thiasotiks/Audio-Preamplifier-With-3-band-Equalizer/README.md

# Audio-Preamplifier-With-3-band-Equalizer 
This repo contains the PCB layout and circuit diagram for audio preamplifier with *3 band equalizer* and *crossover* filter for subwoofer.<br/><br/><br/>

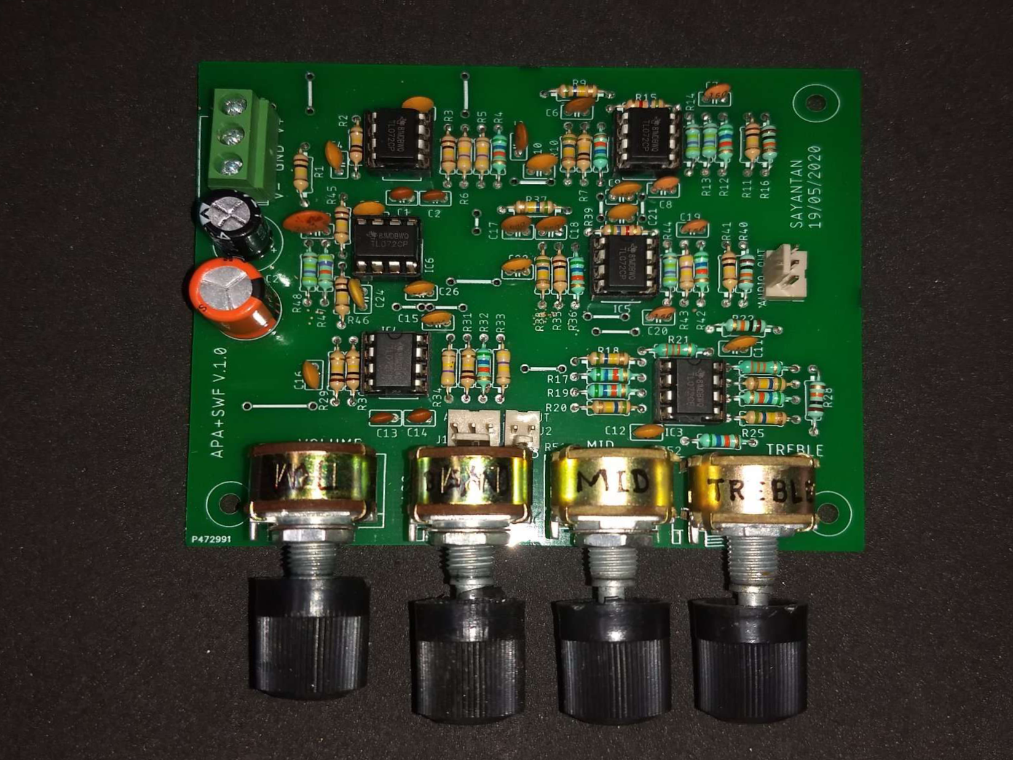
[picture p1: image/circuit-in-use.png]
CIRCUIT IN USE

<br/>**Figure:** The preamplifier circuit board

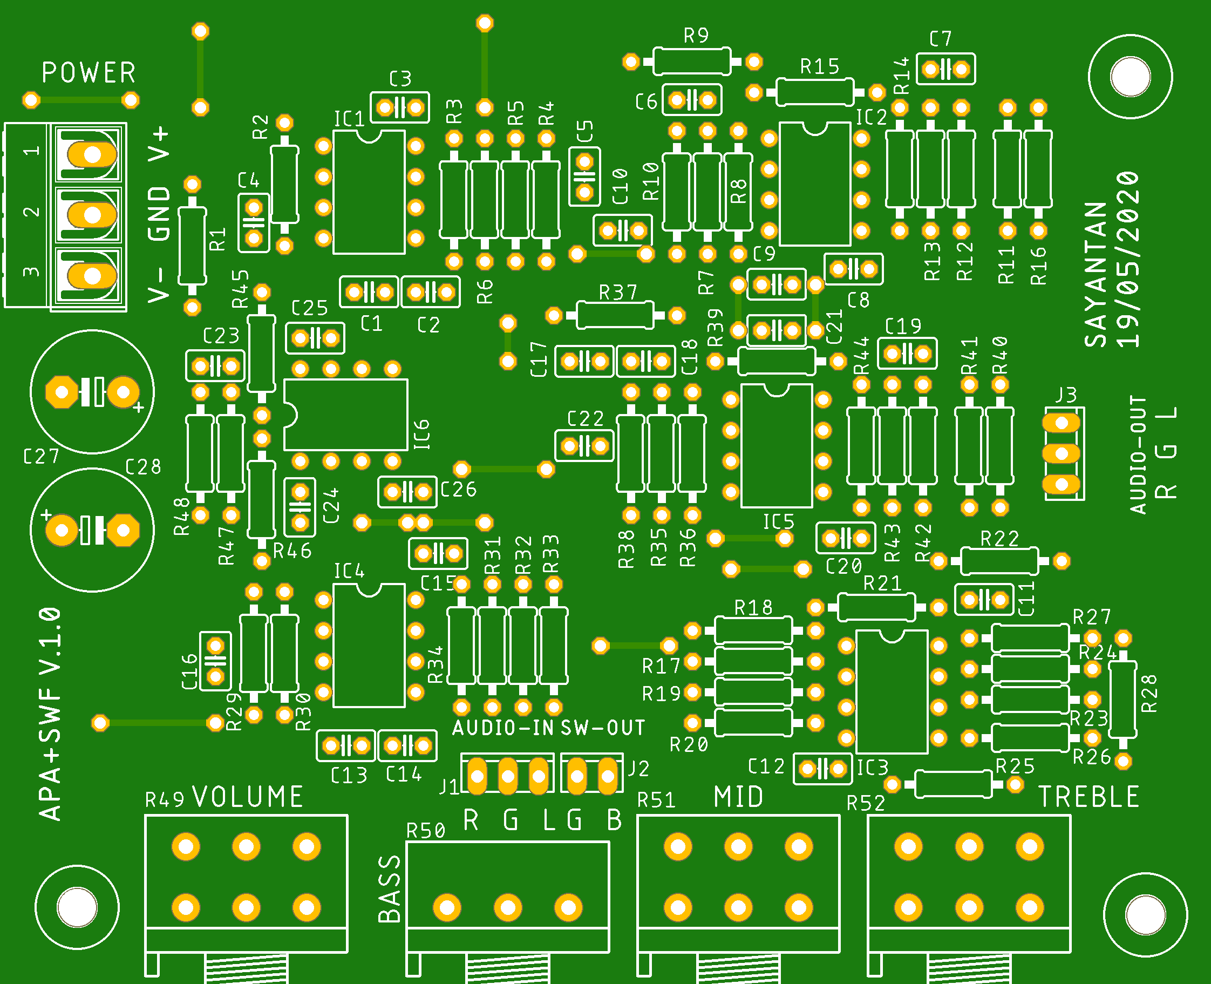
[picture p2: image/pcb-top.png]
PCB TOP

<br/>**Figure:** PCB top

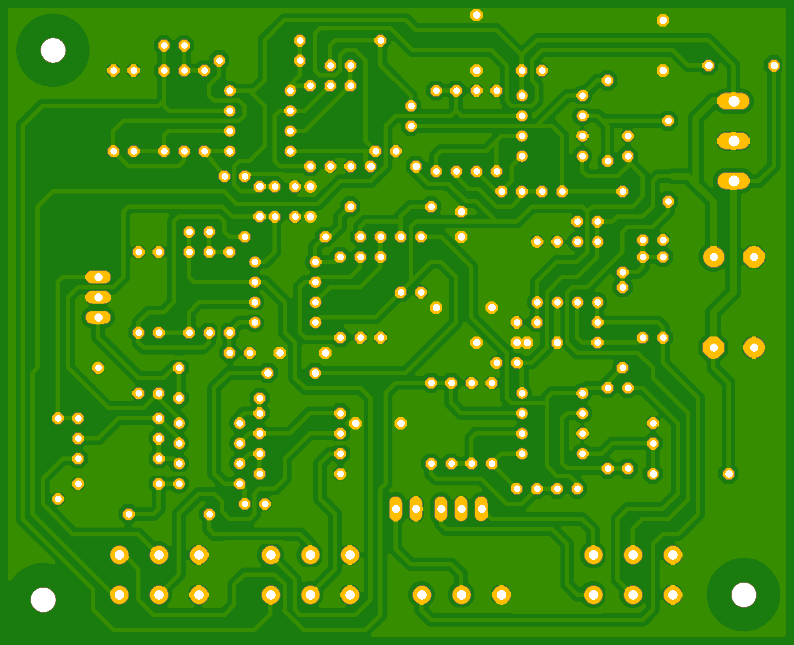
[picture p3: image/pcb-bottom.png]
PCB BOTTOM

<br/>**Figure:** PCB bottom

## Table of damping ratio for designing Butterworth filter of different orders.
|Order||Stages|||
|-----|---|---|-----|-----|
|1|Stage-A: <br/>1st Order||||
|2|Stage-A: <br/>2nd Order; k = 0.707||||
|3|Stage-A: <br/>1st Order|Stage-B: <br/>2nd Order; k = 0.5|||
|4|Stage-A: <br/>2nd Order; k = 0.3825|Stage-B: <br/>2nd Order; k = 0.924|||
|5|Stage-A: <br/>1st Order|Stage-B: <br/>2nd Order; k = 0.309|Stage-C: <br/>2nd Order; k = 0.809||
|6|Stage-A: <br/>2nd Order; k = 0.259|Stage-B: <br/>2nd Order; k = 0.707|Stage-C: <br/>2nd Order; k = 0.966||
|7|Stage-A: <br/>1st Order|Stage-B: <br/>2nd Order; k = 0.2225|Stage-C: <br/>2nd Order; k = 0.6235|Stage-D: <br/>2nd Order; k = 0.901|
|8|Stage-A: <br/>2nd Order; k = 0.190|Stage-B: <br/>2nd Order; k = 0.5555|Stage-C: <br/>2nd Order; k = 0.8315|Stage-D: <br/>2nd Order; k = 0.981|
---

>**NOTE:** k is the damping ratio of the filter which decides the response of the filter. Quality factor, Q = 1 / 2k.

## Designing the low-pas filter for BASS band (also acts as a crossover filter for subwoofer)
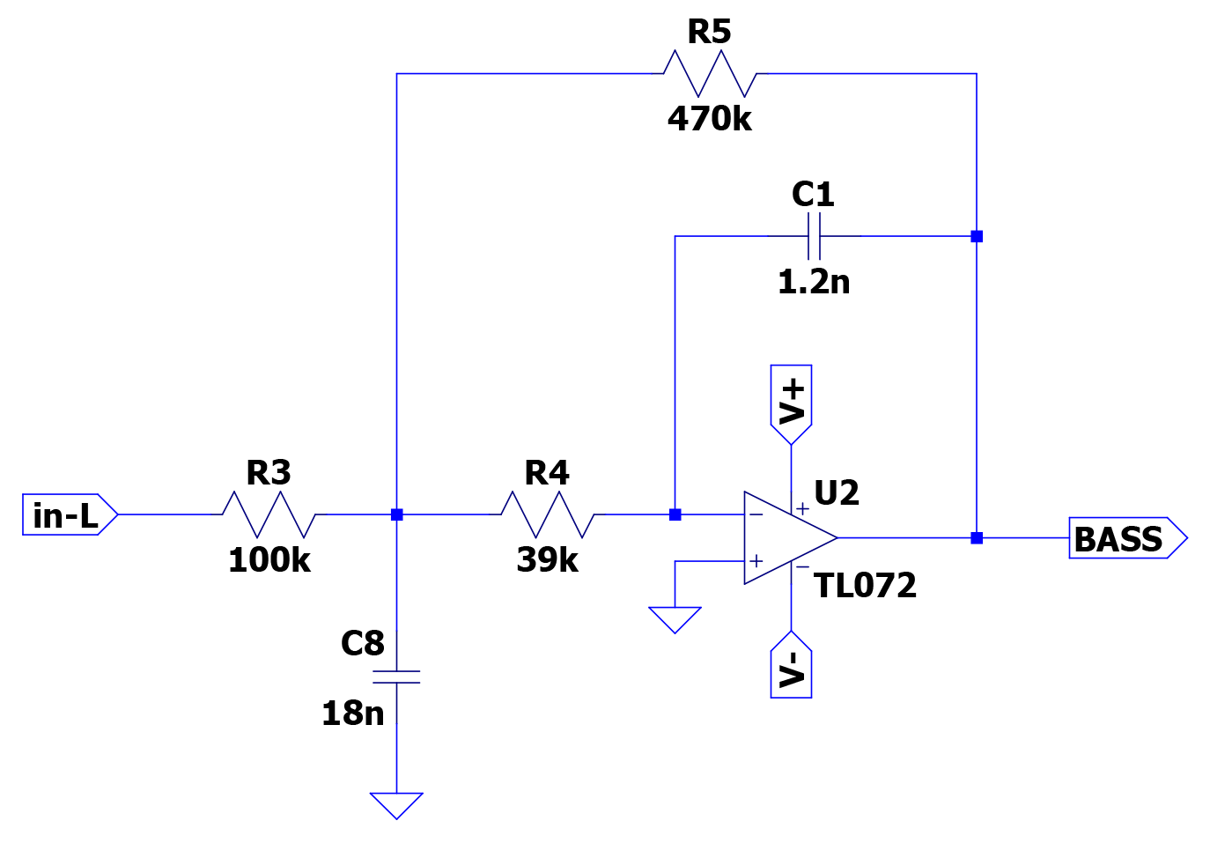
[picture p4: image/lpf-bass.png]
LOW PASS FILTER-BASS

<br/>**Figure:** Low pass filter for BASS-band

**Filter type:** 2nd order Butterworth low-pass, multiple feedback filter <br/>
**Target:** |gain| = 4 (12 dB), cutoff freq., f_c = 250 Hz, k = 0.707 <br/>
**Designed:**
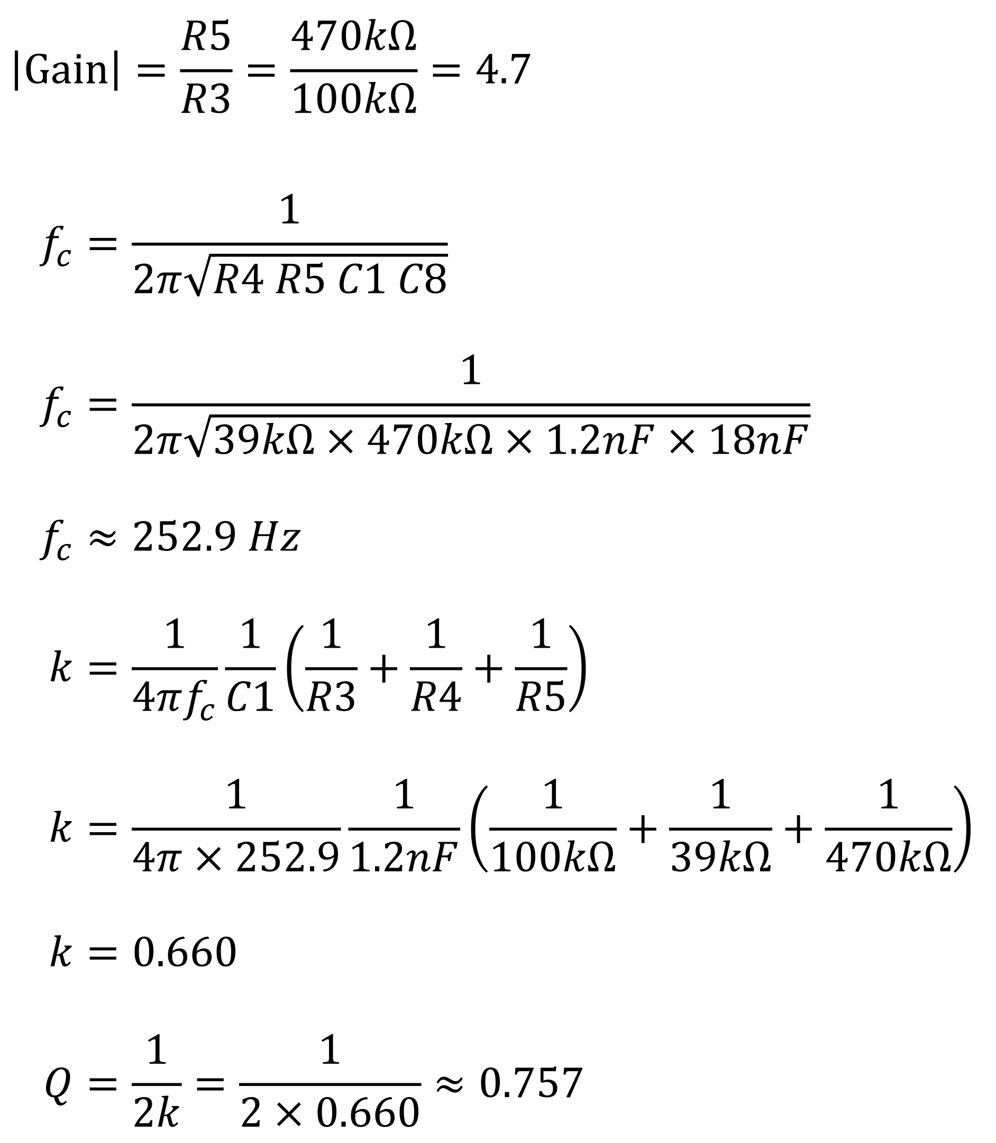
[picture p5: image/bass-filter-calc.png]
BASS FILTER CALC


## Designing the band-pass filter for MID band
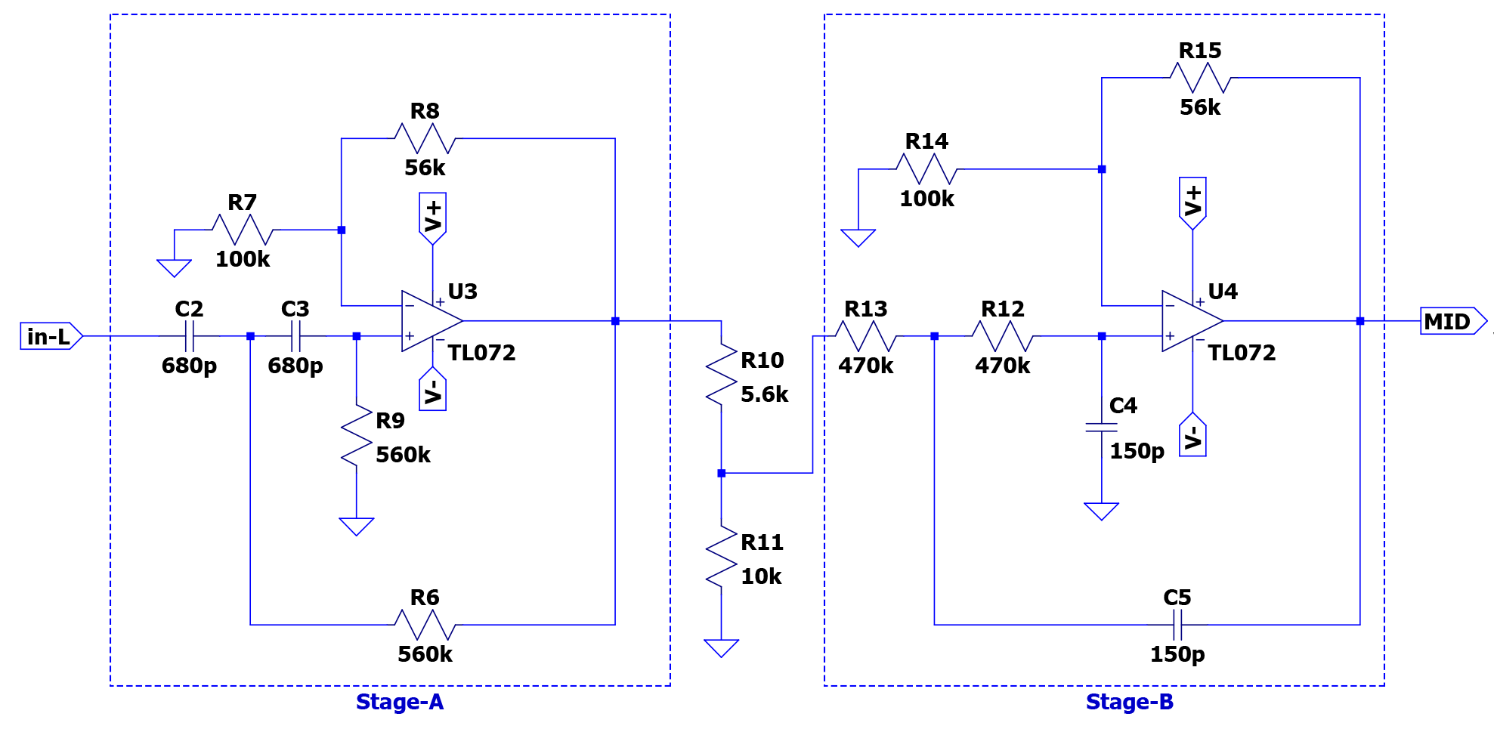
[picture p6: image/bpf-mid.png]
BAND PASS FILTER-MID

<br/>**Figure:** Band pass filter for MID-band

**Filter type:** 2nd order mid-pass, cascade two Sallen-Key filters (stage-A & stage-B) <br/>
### Stage-A (2nd order Butterworth high-pass filter)
**Target:** gain = 3 - 2k = 3 - 2 * 0.707 = 1.586, f_c = 420 Hz, k = 0.707 <br/>
**Designed:**
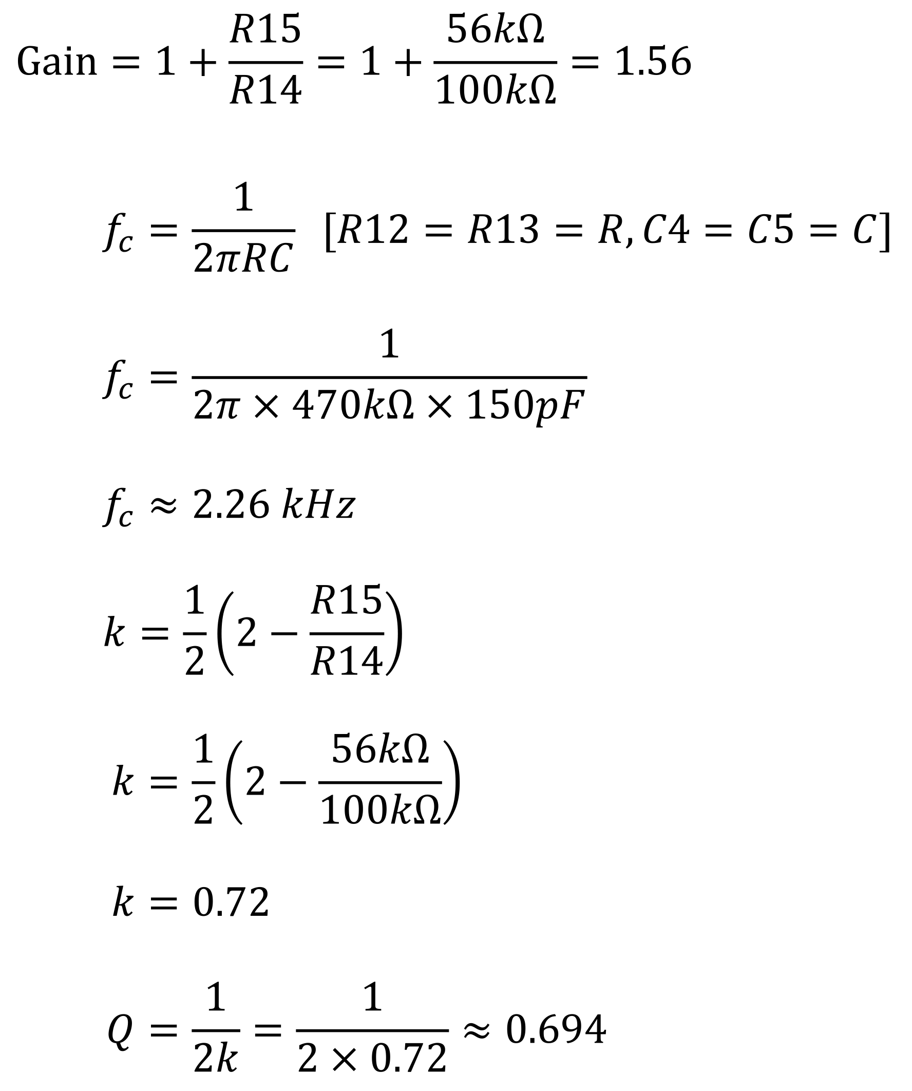
[picture p7: image/mid-filter-a-calc.png]
MID FILTER A CALC


### Stage-B (2nd order Butterworth low-pass filter)
**Target:** gain = 3 - 2k = 3 - 2 * 0.707 = 1.586, f_c = 2.30 kHz, k = 0.707 <br/>
**Designed:**
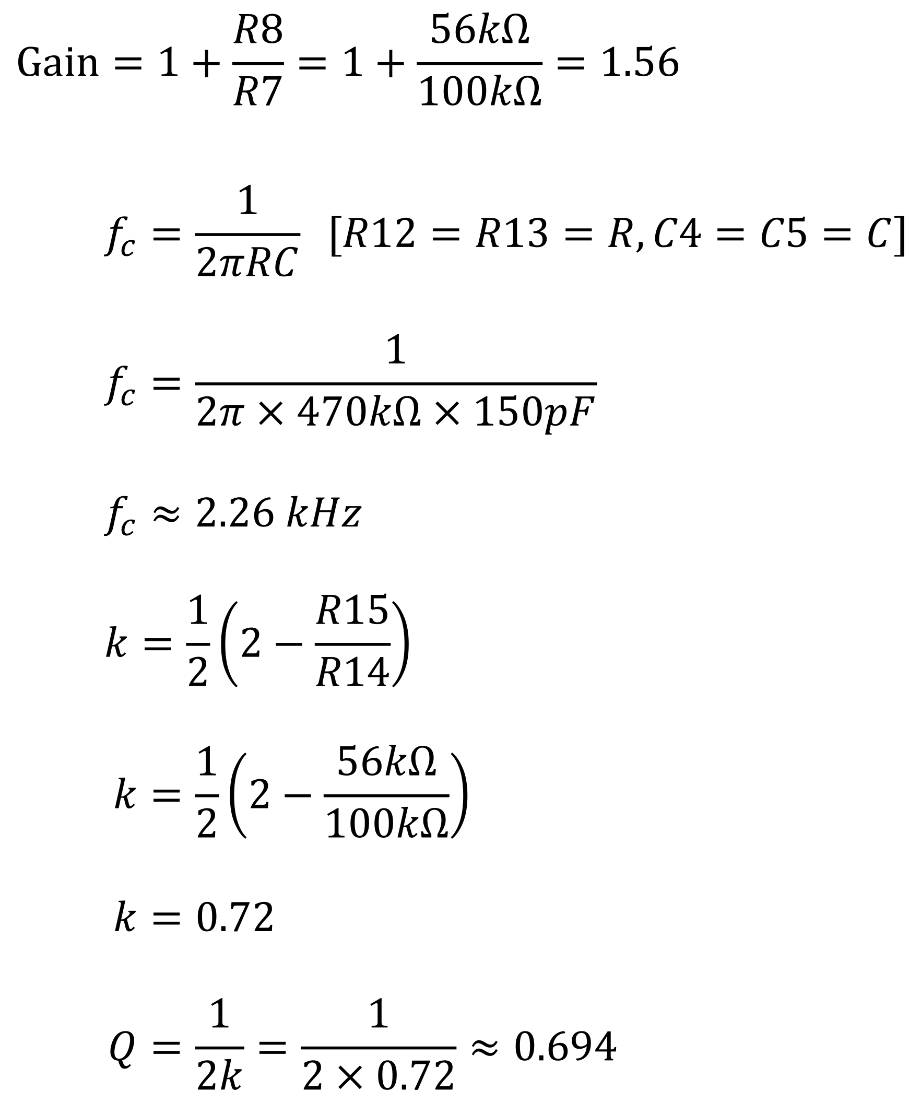
[picture p8: image/mid-filter-b-calc.png]
MID FILTER B CALC


## Designing the low-pass filter for TREBLE band
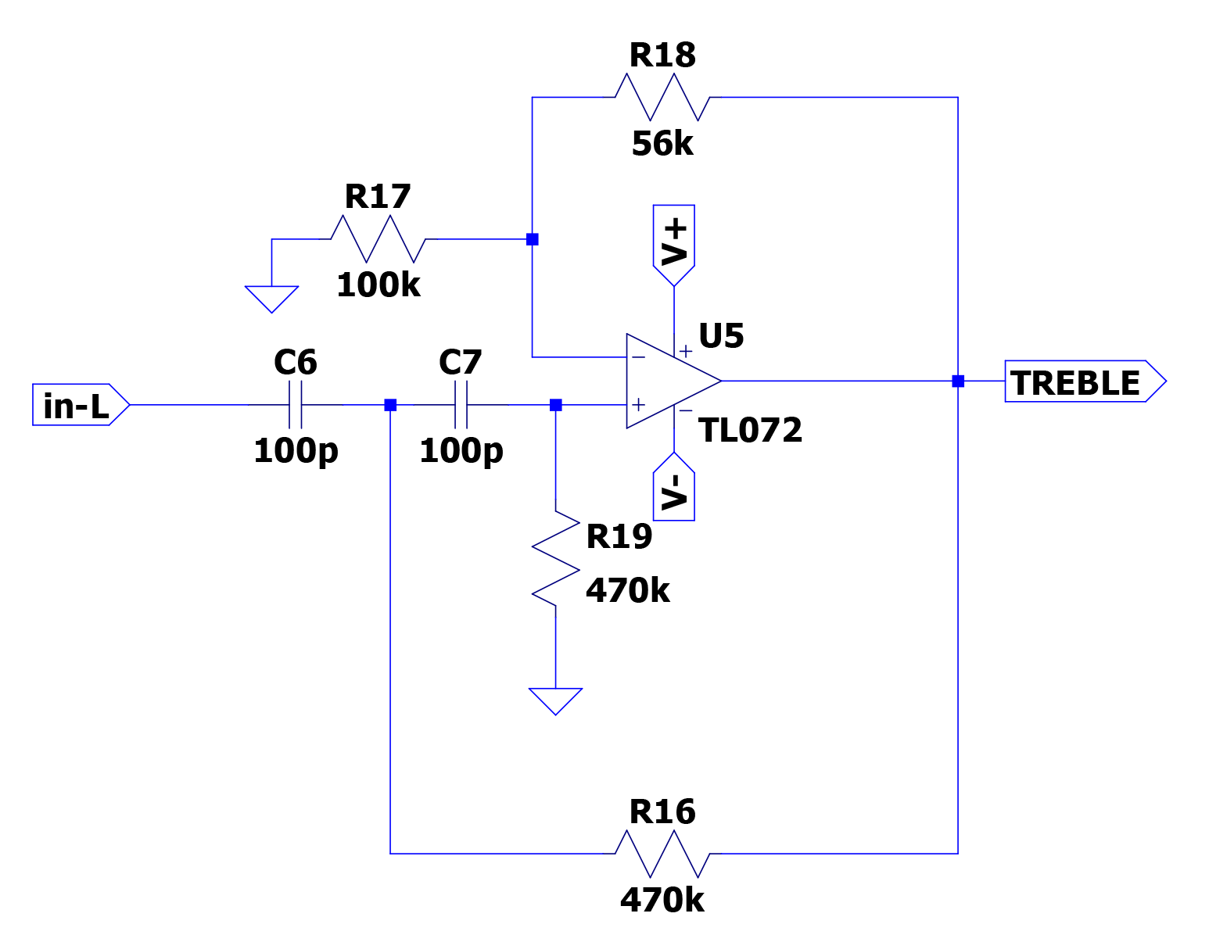
[picture p9: image/hpf-treble.png]
LOW PASS FILTER-TREBLE

<br/>**Figure:** Low pass filter for TREBLE-band

**Filter type:** 2nd order Butterworth low-pass, Sallen-Key filter <br/>
**Target:** gain = 3 - 2k = 3 - 2 * 0.707 = 1.586, f_c = 3.30 kHz, k = 0.707 <br/>
**Designed:**
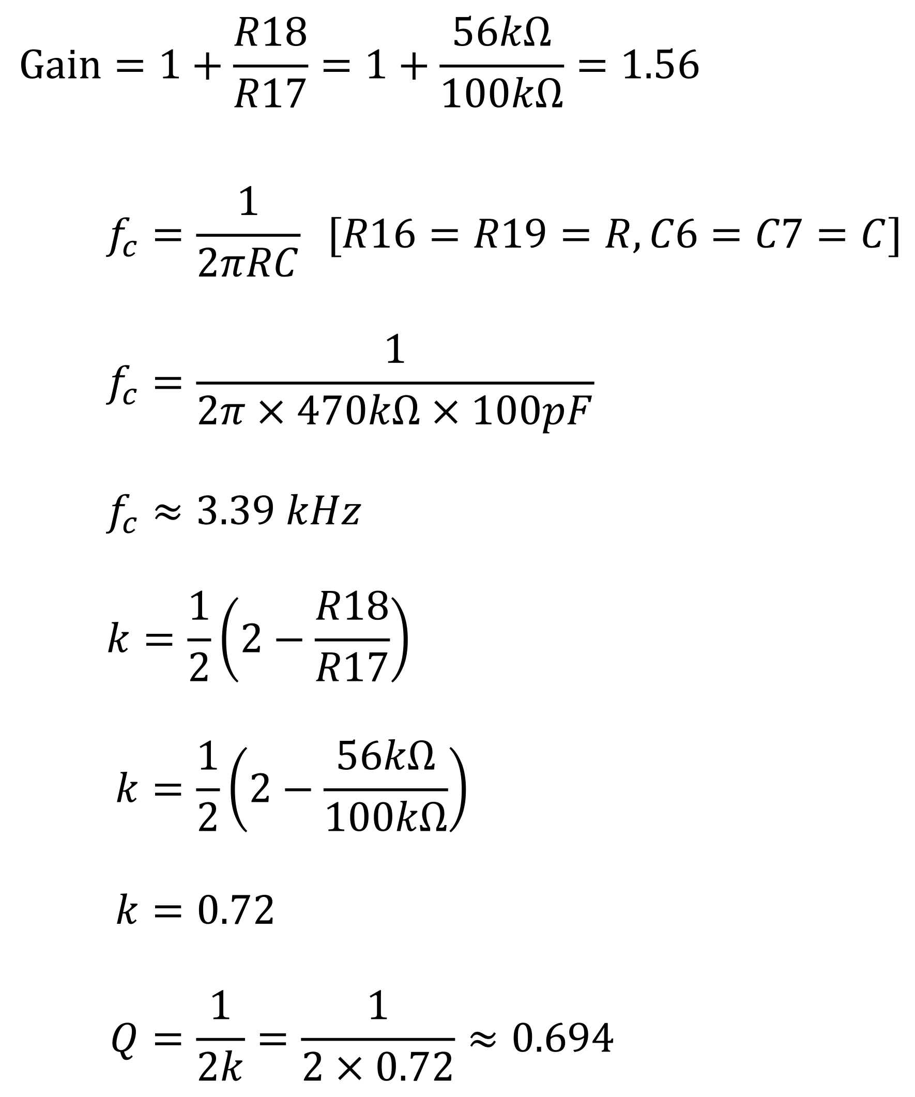
[picture p10: image/treble-filter-calc.png]
TREBLE FILTER CALC


>**NOTE:** Before running simulation in LT Spice "potentiometer.asc" & "potentiometer.asy" must be copied to appropriate symbol folder (e.g. C:\Users\<User Name>\Documents\LTspiceXVII\lib\sym) and copy the TL072.LIB to the "sub" folder (e.g. C:\Users\<User Name>\Documents\LTspiceXVII\lib\sub)

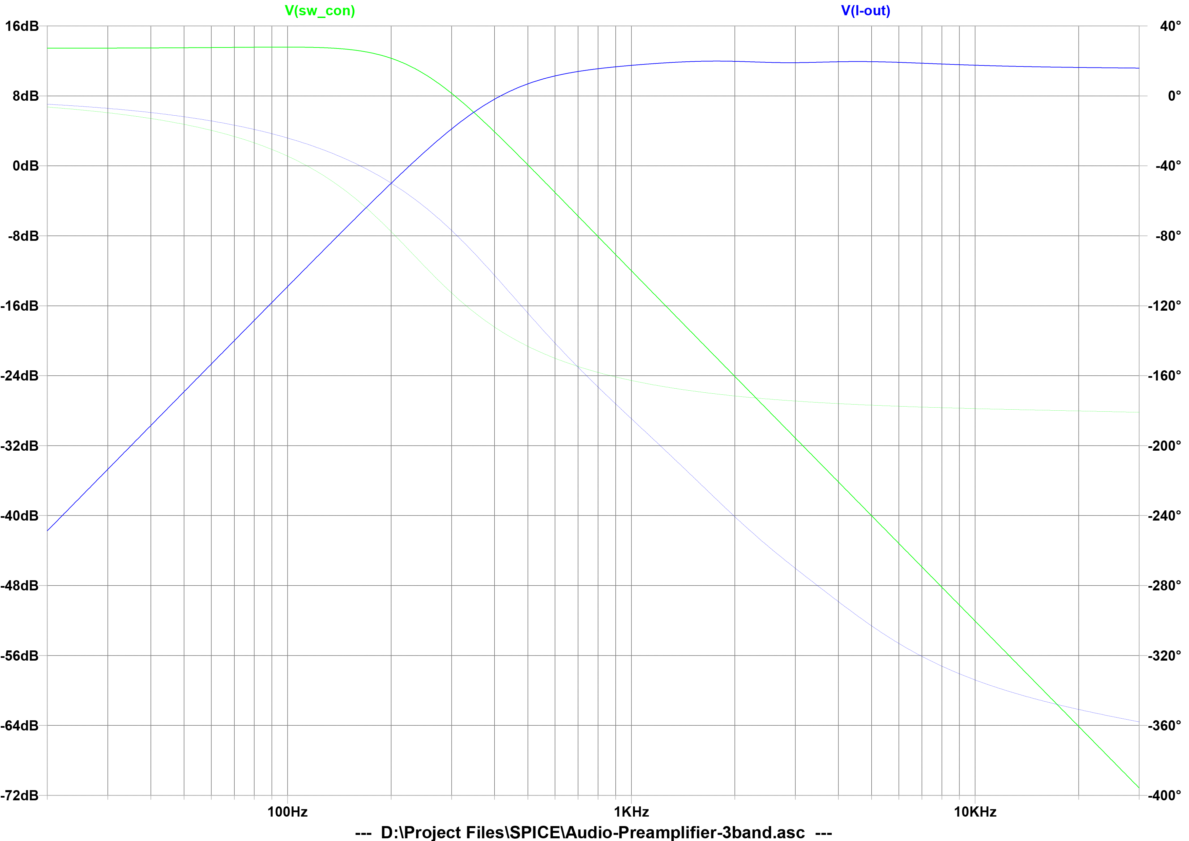
[picture p11: image/Audio-Preamplifier-3band-Response-100-100-100.png]
OUTPUT CURVE-B-100%, M-100%, T-100%

<br/>**Figure:** OUTPUT CURVE-BASS=100%, MID=100%, TREBLE=100%

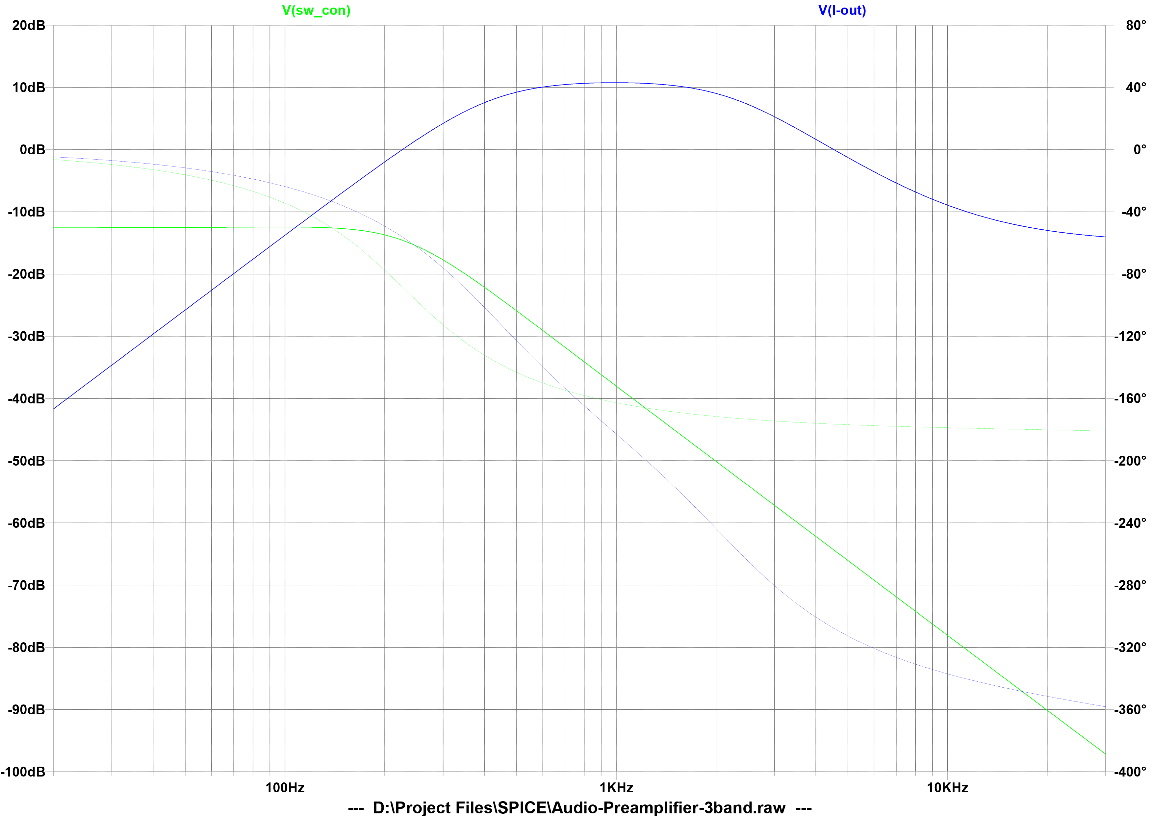
[picture p12: image/Audio-Preamplifier-3band-Response-5-100-5.png]
OUTPUT CURVE-B-5%, M-100%, T-5%

<br/>**Figure:** OUTPUT CURVE-BASS=5%, MID=100%, TREBLE=5%

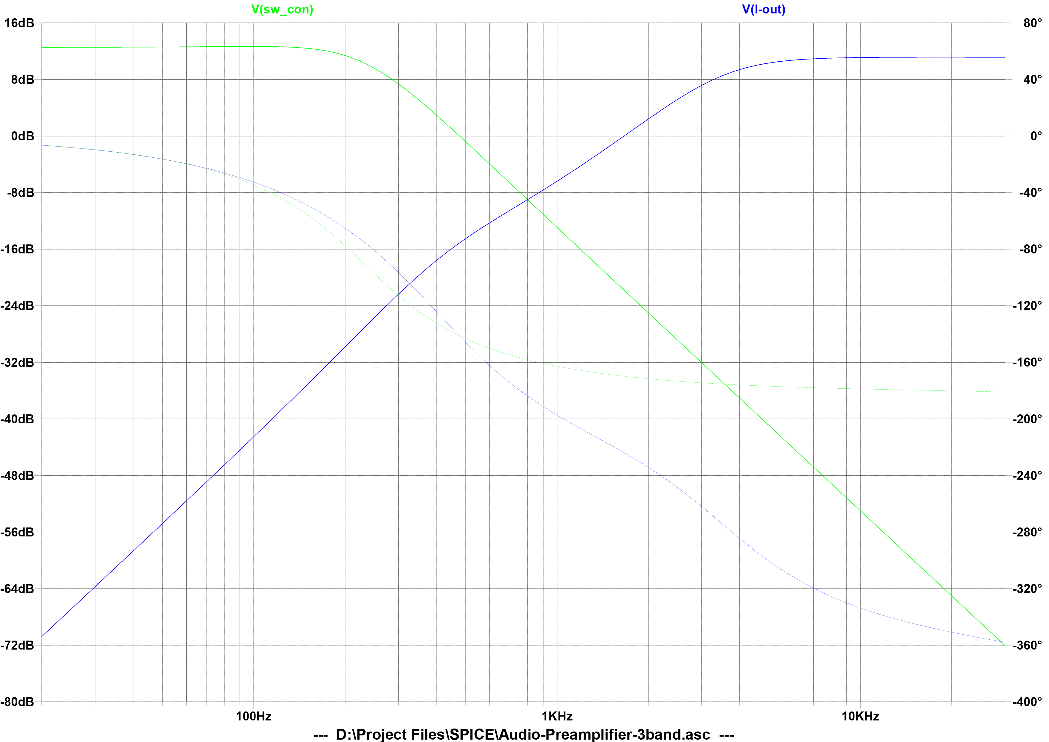
[picture p13: image/Audio-Preamplifier-3band-Response-90-5-100.png]
OUTPUT CURVE-B-90%, M-5%, T-100%

<br/>**Figure:** >OUTPUT CURVE-BASS=90%, MID=5%, TREBLE=100%

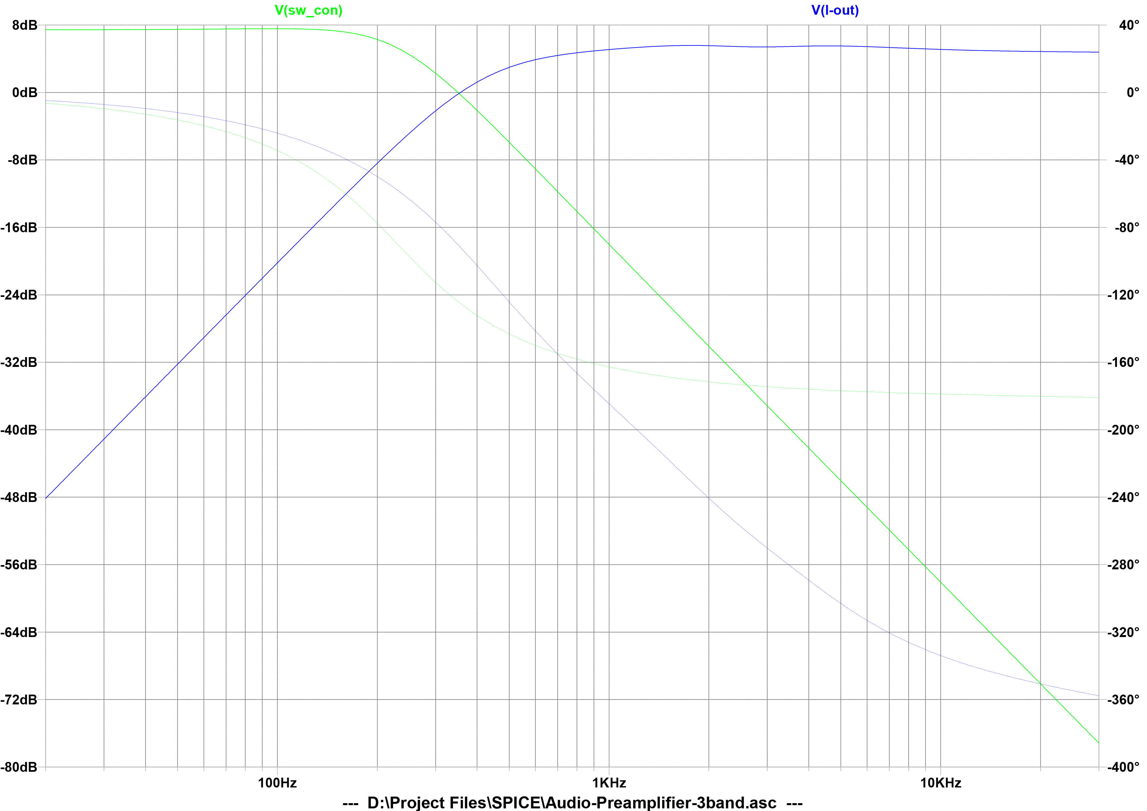
[picture p14: image/Audio-Preamplifier-3band-Response-50-50-50.png]
OUTPUT CURVE-B-50%, M-50%, T-50%

<br/>**Figure:** OUTPUT CURVE-BASS=50%, MID=50%, TREBLE=50%

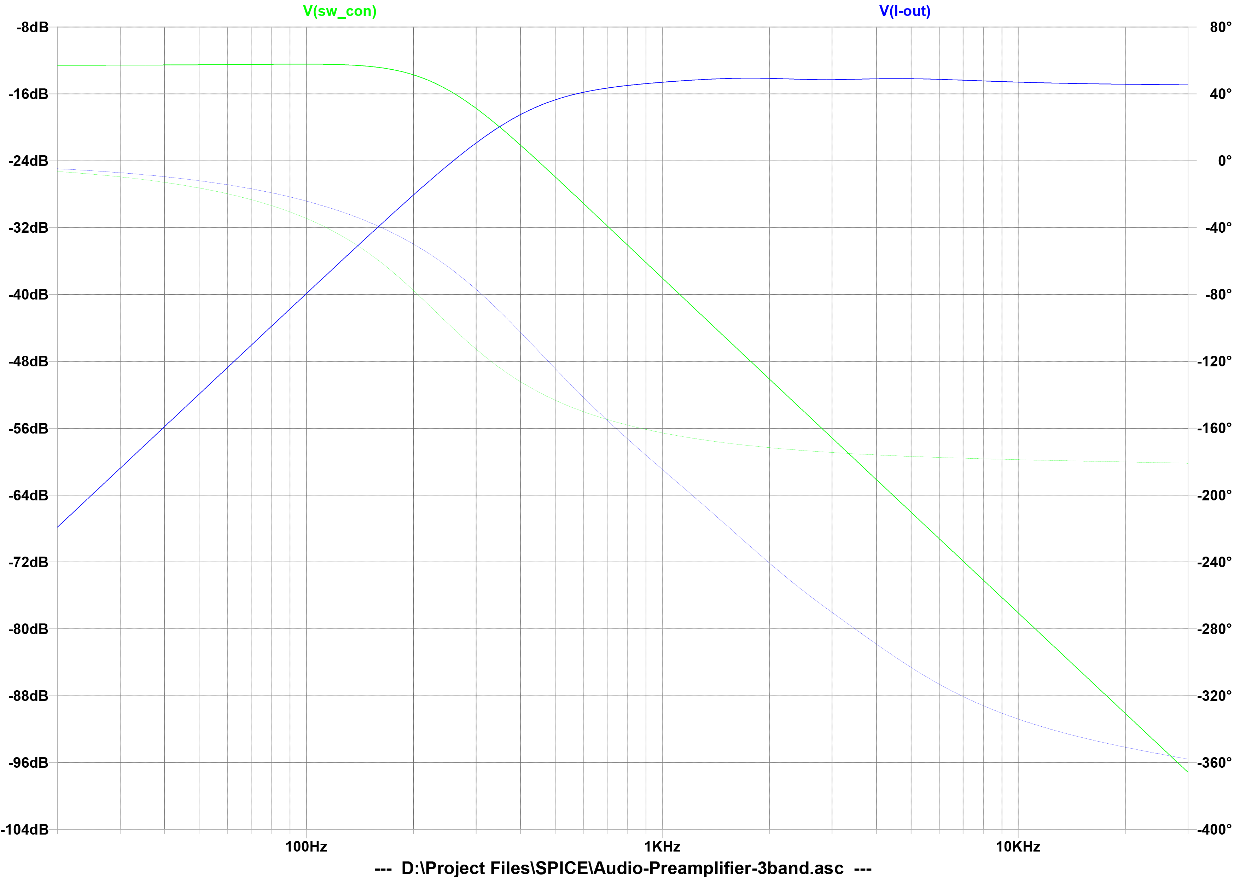
[picture p15: image/Audio-Preamplifier-3band-Response-5-5-5.png]
OUTPUT CURVE-B-5%, M-5%, T-5%

<br/>**Figure:** OUTPUT CURVE-BASS=5%, MID=5%, TREBLE=5%

## References
- [Wath the video on YouTube](https://youtu.be/h-8pL9eNuU0)
- [Schematic](./Schematic/Schematic-Basic.pdf)
- [OKAWA Electric Design](http://sim.okawa-denshi.jp/en/Fkeisan.htm)
- [Integrated Electronics by Millman & Halkias](https://books.google.co.in/books/about/Integrated_Electronics.html?id=Qta8v9hJBMAC)
