thiasotiks/Audio-Preamplifier-With-3-band-Equalizer/Schematic/Schematic-Eagle-Full Circuit.pdf

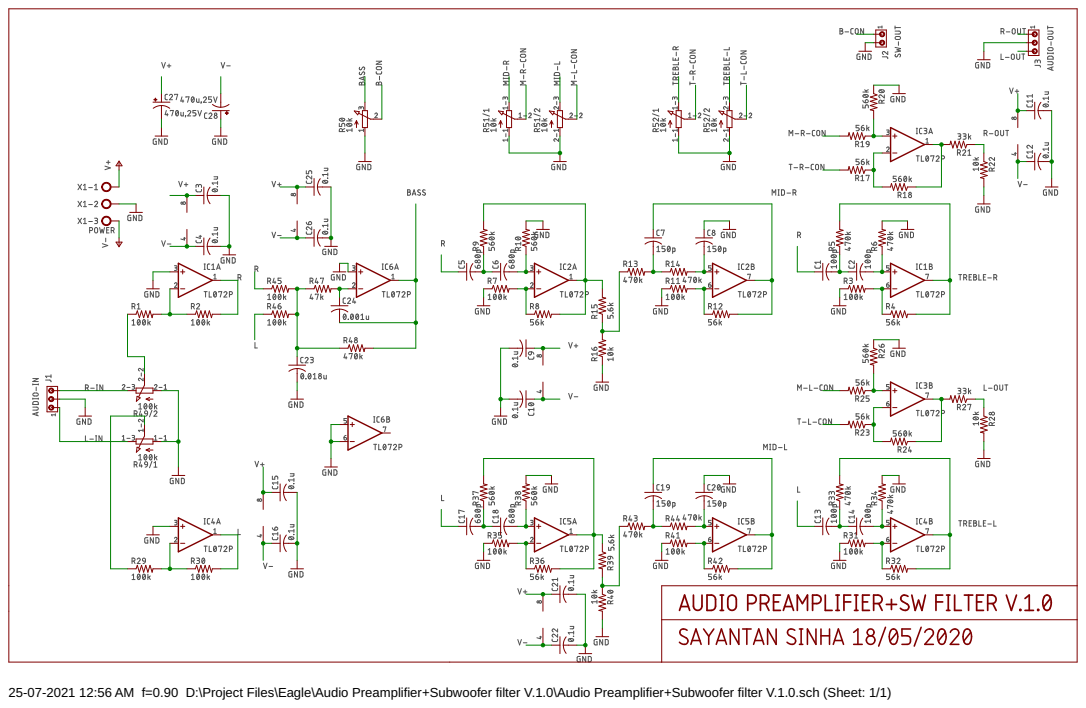
[picture p16: page 1]

25-07-2021 12:56 AM f=0.90 D:\Project Files\Eagle\Audio Preamplifier+Subwoofer filter V.1.0\Audio Preamplifier+Subwoofer filter V.1.0.sch (Sheet: 1/1)
