thiasotiks/Audio-Preamplifier-With-3-band-Equalizer/Schematic/Schematic-Basic.pdf

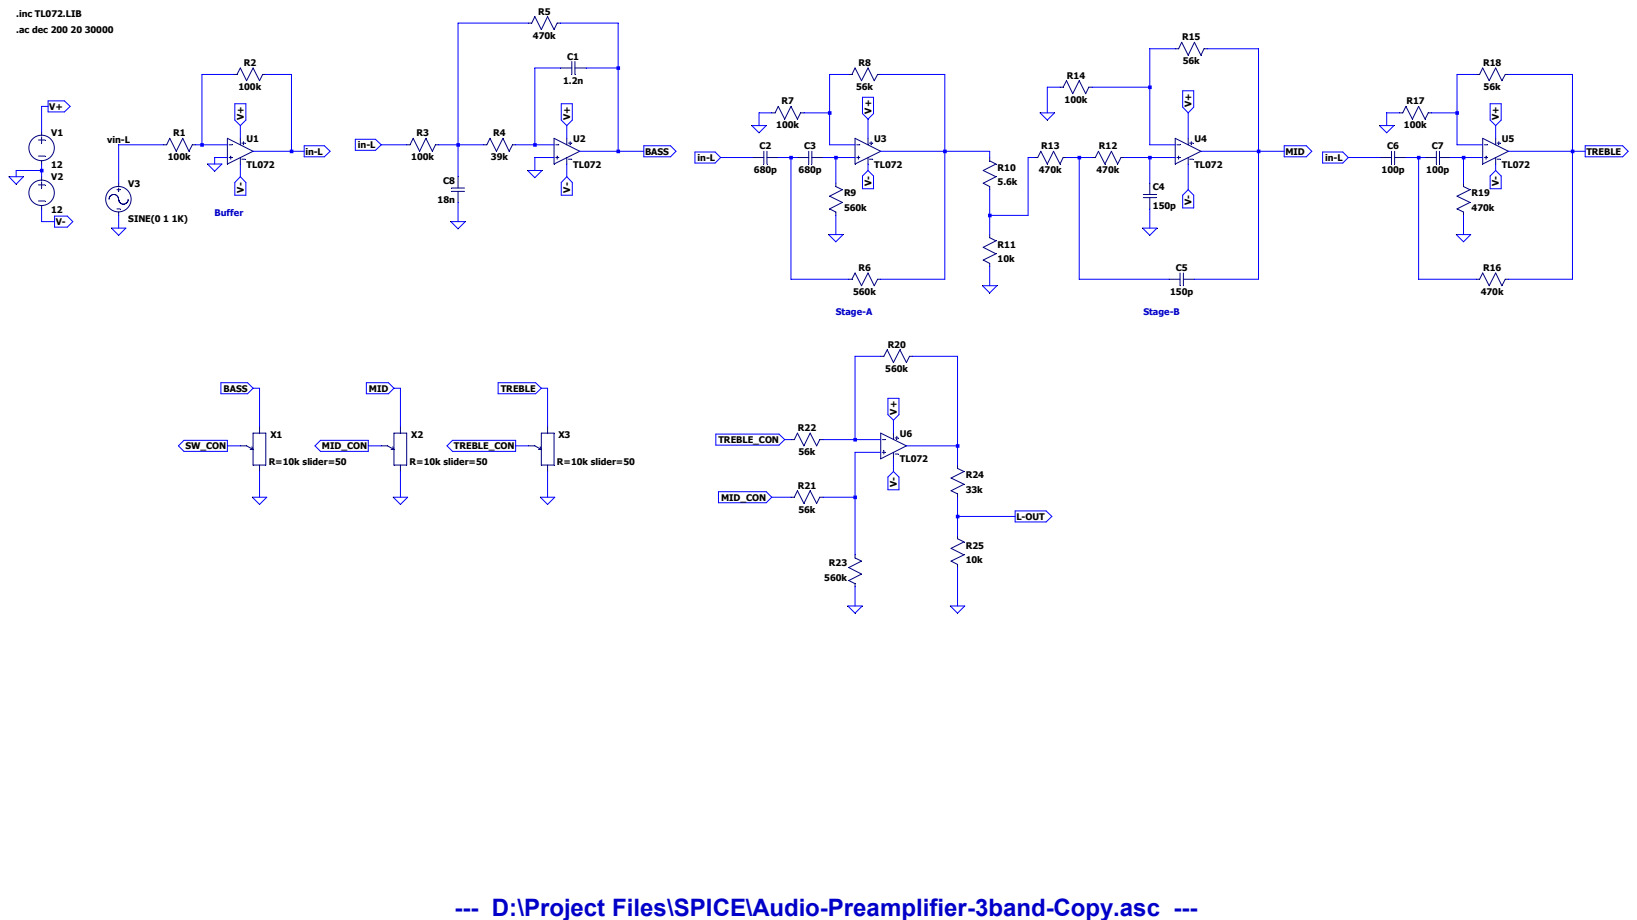
[picture p17: page 1]

--- D:\Project Files\SPICE\Audio-Preamplifier-3band-Copy.asc ---
