thiasotiks/Audio-Preamplifier-With-3-band-Equalizer/LTSpice-Sim/Audio-Preamplifier-LTSpice.asc

C1: cap; 1.2n
C2: cap; 680p
C3: cap; 680p
C4: cap; 150p
C5: cap; 150p
C6: cap; 100p
C7: cap; 100p
C8: cap; 18n
R1: res; 100k
R2: res; 100k
R3: res; 100k
R4: res; 39k
R5: res; 470k
R6: res; 560k
R7: res; 100k
R8: res; 56k
R9: res; 560k
R10: res; 5.6k
R11: res; 10k
R12: res; 470k
R13: res; 470k
R14: res; 100k
R15: res; 56k
R16: res; 470k
R17: res; 100k
R18: res; 56k
R19: res; 470k
R20: res; 560k
R21: res; 56k
R22: res; 56k
R23: res; 560k
R24: res; 33k
R25: res; 10k
U1: opamp2; TL072
U2: opamp2; TL072
U3: opamp2; TL072
U4: opamp2; TL072
U5: opamp2; TL072
U6: opamp2; TL072
V1: voltage; 12
V2: voltage; 12
V3: signal; AC 1 0
X1: potentiometer; R=10k slider=50
X2: potentiometer; R=10k slider=50
X3: potentiometer; R=10k slider=50
Named nets: 0, V+, V-, vin-L, in-L, BASS, MID, TREBLE, SW_CON, MID_CON, TREBLE_CON, L-OUT
.inc TL072.LIB
.ac dec 200 20 30000
Buffer
Stage-A
Stage-B
